toxsedyshev/imBMW/README.md

imBMW · BMW iBus integration SDK and hardware
=========================

[imBMW]: http://imBMW.net "imBMW"
[toxs]: http://toxs.ru "toxs"

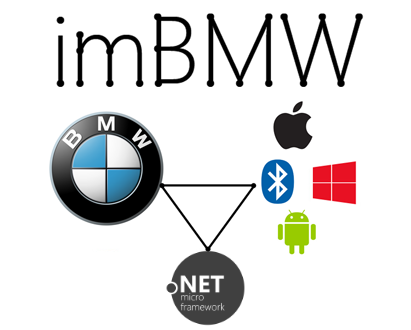
[picture p1: Images/splash.png]
imBMW Splash


[imBMW] is .NET Micro Framework and hardware project. It was started to add custom features to cars with **iBus** interface such as '91-'10 BMWs and some models of Mini, Land Rover, Rover, MG and Rolls Royce. Then **CAN BUS** support was added to integrate with newer F,I,G-series BMWs.

The Original **imBMW V1** device uses **FEZ Mini**, connects with iPod/iPhone via headset cable to be controlled by BMW audio system.

The Next Gen **imBMW V2** device, that uses **STM32F405** based **FEZ Cerb40 II**, is a *duino-compatible iBus-ready board. It could be used with any shield, for example with **imBMW Bluetooth OVC3860** or **Bluetooth Pro Bluegiga WT32 Shields** for wireless stereo audio connection to BMW audio system, handsfree calls and even for forwarding iBus via Bluetooth to smartphones, tablets and PCs - imBMW already has a library for **Universal Windows Platform (UWP)**. There is also **Diagnostic Bus DS2** support using regular OBD II to USB adapter, that allows Engine Control Unit plus additional sensors logging and wireless Bluetooth dashboard. Furthermore, **CAN BUS** support was added for sniffing and integrating with CAN modules of all BMWs since the end 90's till latest BMW models including i-series EVs — for example, CAN BUS integration allowed to [integrate BMW E65 full comfort seats into older BMW E53](https://www.youtube.com/watch?v=P0yJuep_bd4&list=PLDuwqawzvazj9iFQQ9aeggeXeUPphfv94&index=5&pp=gAQBiAQB).

CD-changer emulator and Bordmonitor AUX interface were implemented to connect radio with iPod/iPhone/iPad or with other players, phones and tablets like Windows Phone, Android etc. 
Also imBMW allows communicating with instrument cluster, immobilizer, GM, ZKE, navigation and other modules to receive notifications and control doors, windows, lights, etc.

How to buy imBMW
------------------
**Please note: I used to manufacture and sell imBMW devices but I DON'T sell them anymore.**

You can DIY the project for your personal use as many community members did, some [examples of the device forks are shown here](https://vk.com/album-67915700_260588402).

Social networks
-----------------
* Visit [imBMW YouTube playlist](http://www.youtube.com/playlist?list=PLDuwqawzvazj9iFQQ9aeggeXeUPphfv94) on my channel.
* Official group: [imBMW on vk.com](http://vk.com/imbmw).
* Stay in touch via [imbmw@toxs.ru](mailto:imbmw@toxs.ru), but please remember: I don't sell devices anymore. 
* Photos, videos and creation process of imBMW V1 and V2 devices are located on [e46club.ru forum](http://bmwfanatics.ru/forumvb/viewtopic.php?f=32&t=92399) (for now, only in Russian).

Photos
-
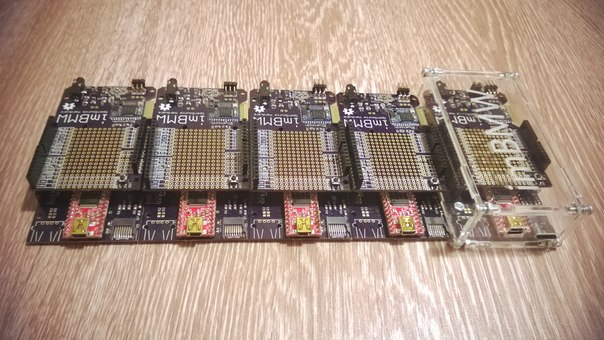
[picture p2: Images/v2_some_items.jpg]
imBMW V2 + Bluetooth first batch


Some screens for example. Playing Bluetooth music, custom bordcomputer, additional features, english and russian UI:  
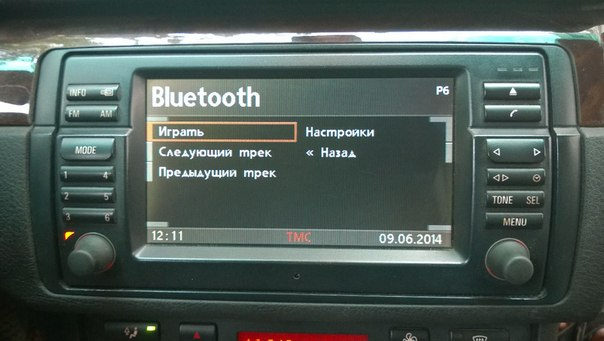
[picture p3: Images/screen_bt.jpg]
imBMW Bluetooth
  
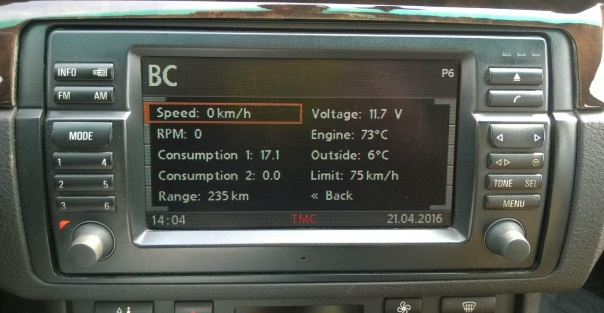
[picture p4: Images/screen_bc_en.jpg]
imBMW Bordcomputer imBMW Bordcomputer Eng
 
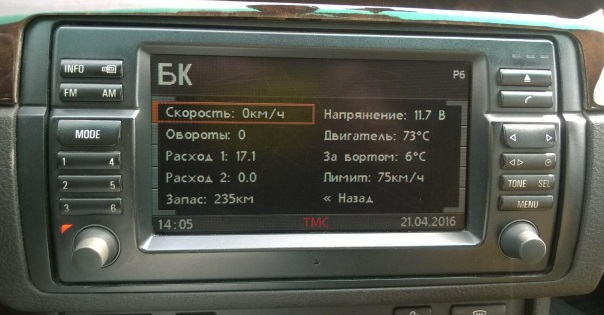
[picture p5: Images/screen_bc_ru.jpg]
imBMW Bordcomputer imBMW Bordcomputer Rus
  
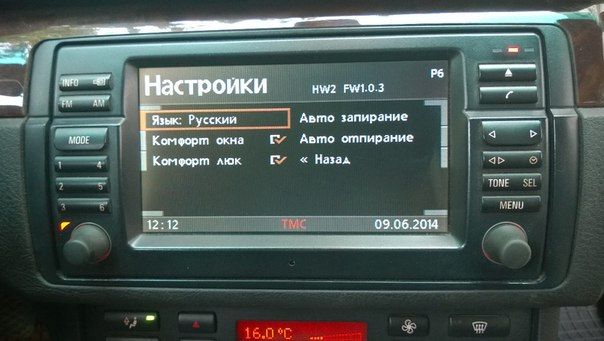
[picture p6: Images/screen_set.jpg]
imBMW Features Settings imBMW Features Settings Rus


imBMW compatability
------------------

iBus-compatible cars are listed below:
* BMW 3-series E46, E36*
* BMW 5-series E39, E34*, E60*
* BMW 7-series E38
* BMW 8-series E31*
* BMW X3 E83
* BMW X5 E53
* BMW Z4 E85, E86
* BMW Z8 E52
* MINI Cooper R50, Cooper S R53
* Land Rover Range Rover L30
* Rover 75 R40
* Saab 9-3 2003+

Notes:
* E31 uses different device IDs.
* Last 2 production years of E36 and E34 had iBus-controlled CD43 radio and CD-changers.
* E60 ver. USA had iBus-controlled seat occupation sensor.

imBMW license
------------------

[imBMW] is developed by [toxs] and distributed under Open Source
[CC Attribution Non-Commercial Share Alike License](http://creativecommons.org/licenses/by-nc-sa/3.0/). 
This basically means:
* Licensees may copy, distribute, display and perform the work and make derivative works 
based on it only if they give the author or licensor the credits in the manner specified by these.
* Licensees may copy, distribute, display, and perform the work and make derivative works 
based on it only for noncommercial purposes.
* Licensees may distribute derivative works only under a license identical to the license 
that governs the original work.

© Copyright 2013-2014 [toxs] · All Rights Reserved
