toxsedyshev/imBMW/Hardware/Cases/V2+Bluetooth_OVC3860/render/q.png

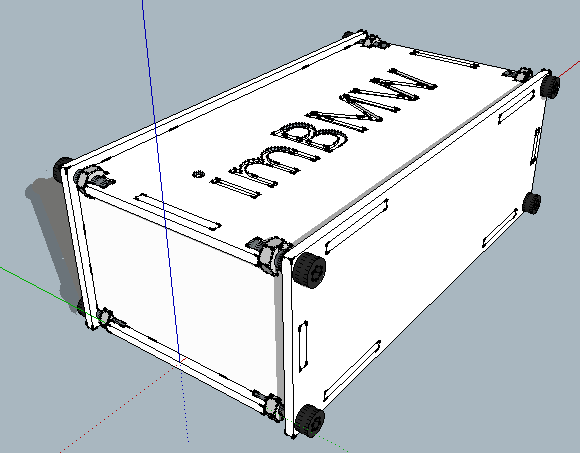
Hardware/Cases/V2+Bluetooth_OVC3860/render/q.png
