toxsedyshev/imBMW/Hardware/Cases/V2+Bluetooth_OVC3860/render/V2_OVC_proto.png

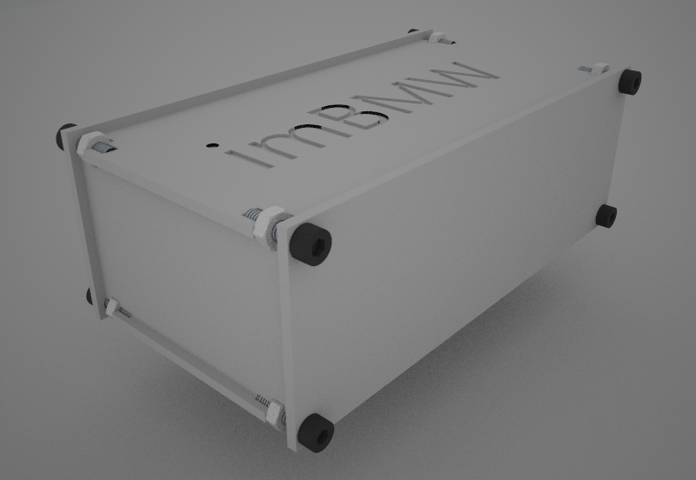
Hardware/Cases/V2+Bluetooth_OVC3860/render/V2_OVC_proto.png
