toxsedyshev/imBMW/Images/screen1.jpg

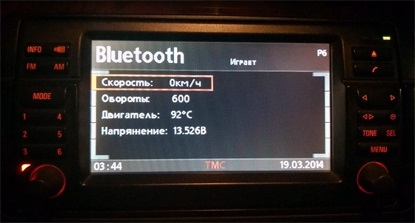
Images/screen1.jpg
