toxsedyshev/imBMW/Images/v2_proto.jpg

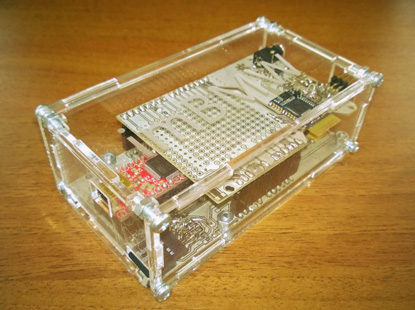
Images/v2_proto.jpg
