toxsedyshev/imBMW/Hardware/Cases/V2+Bluetooth_OVC3860/export/V2_OVC.dxf

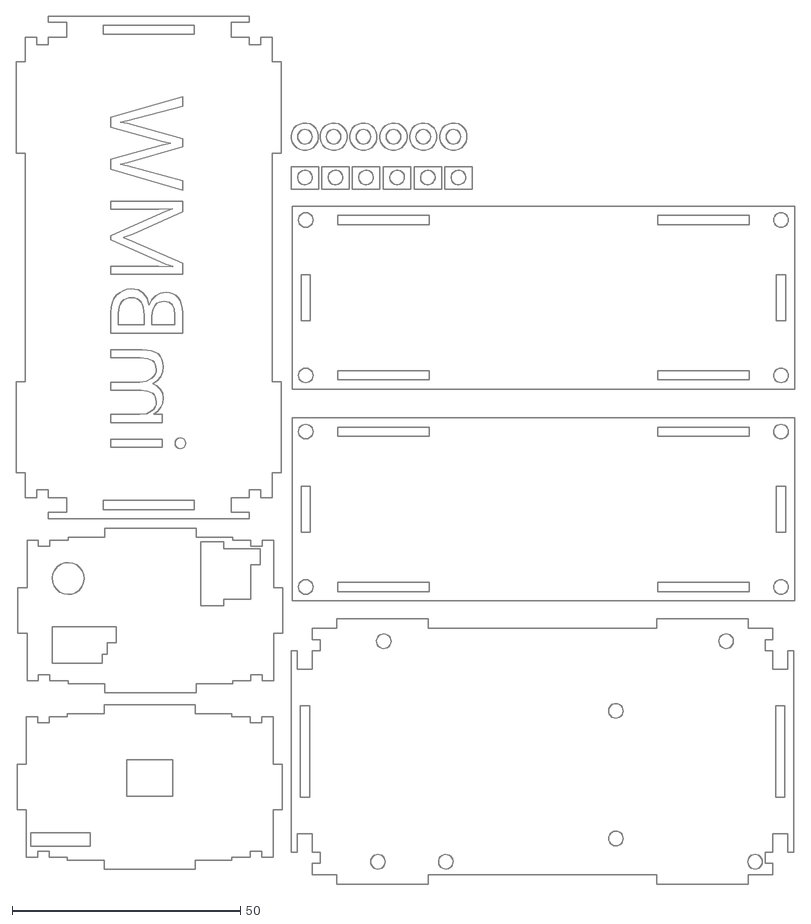
[picture p13: CAD file, 2014-10-19]
Hardware/Cases/V2+Bluetooth_OVC3860/export/V2_OVC.dxf
170.4 x 190.0
