toxsedyshev/imBMW/(list of files, cad)

Other CAD files:
Hardware/Cases/V2+Bluetooth_OVC3860/V2_OVC.skp
