toxsedyshev/imBMW/(list of files, drawings)

Other design files:
Hardware/PCB/V1/v1.DSN
Hardware/PCB/V1/v1.LYT
