toxsedyshev/imBMW/Hardware/PCB/V2/V2.brd

## EAGLE design Hardware/PCB/V2/V2.brd (2014-10-19)

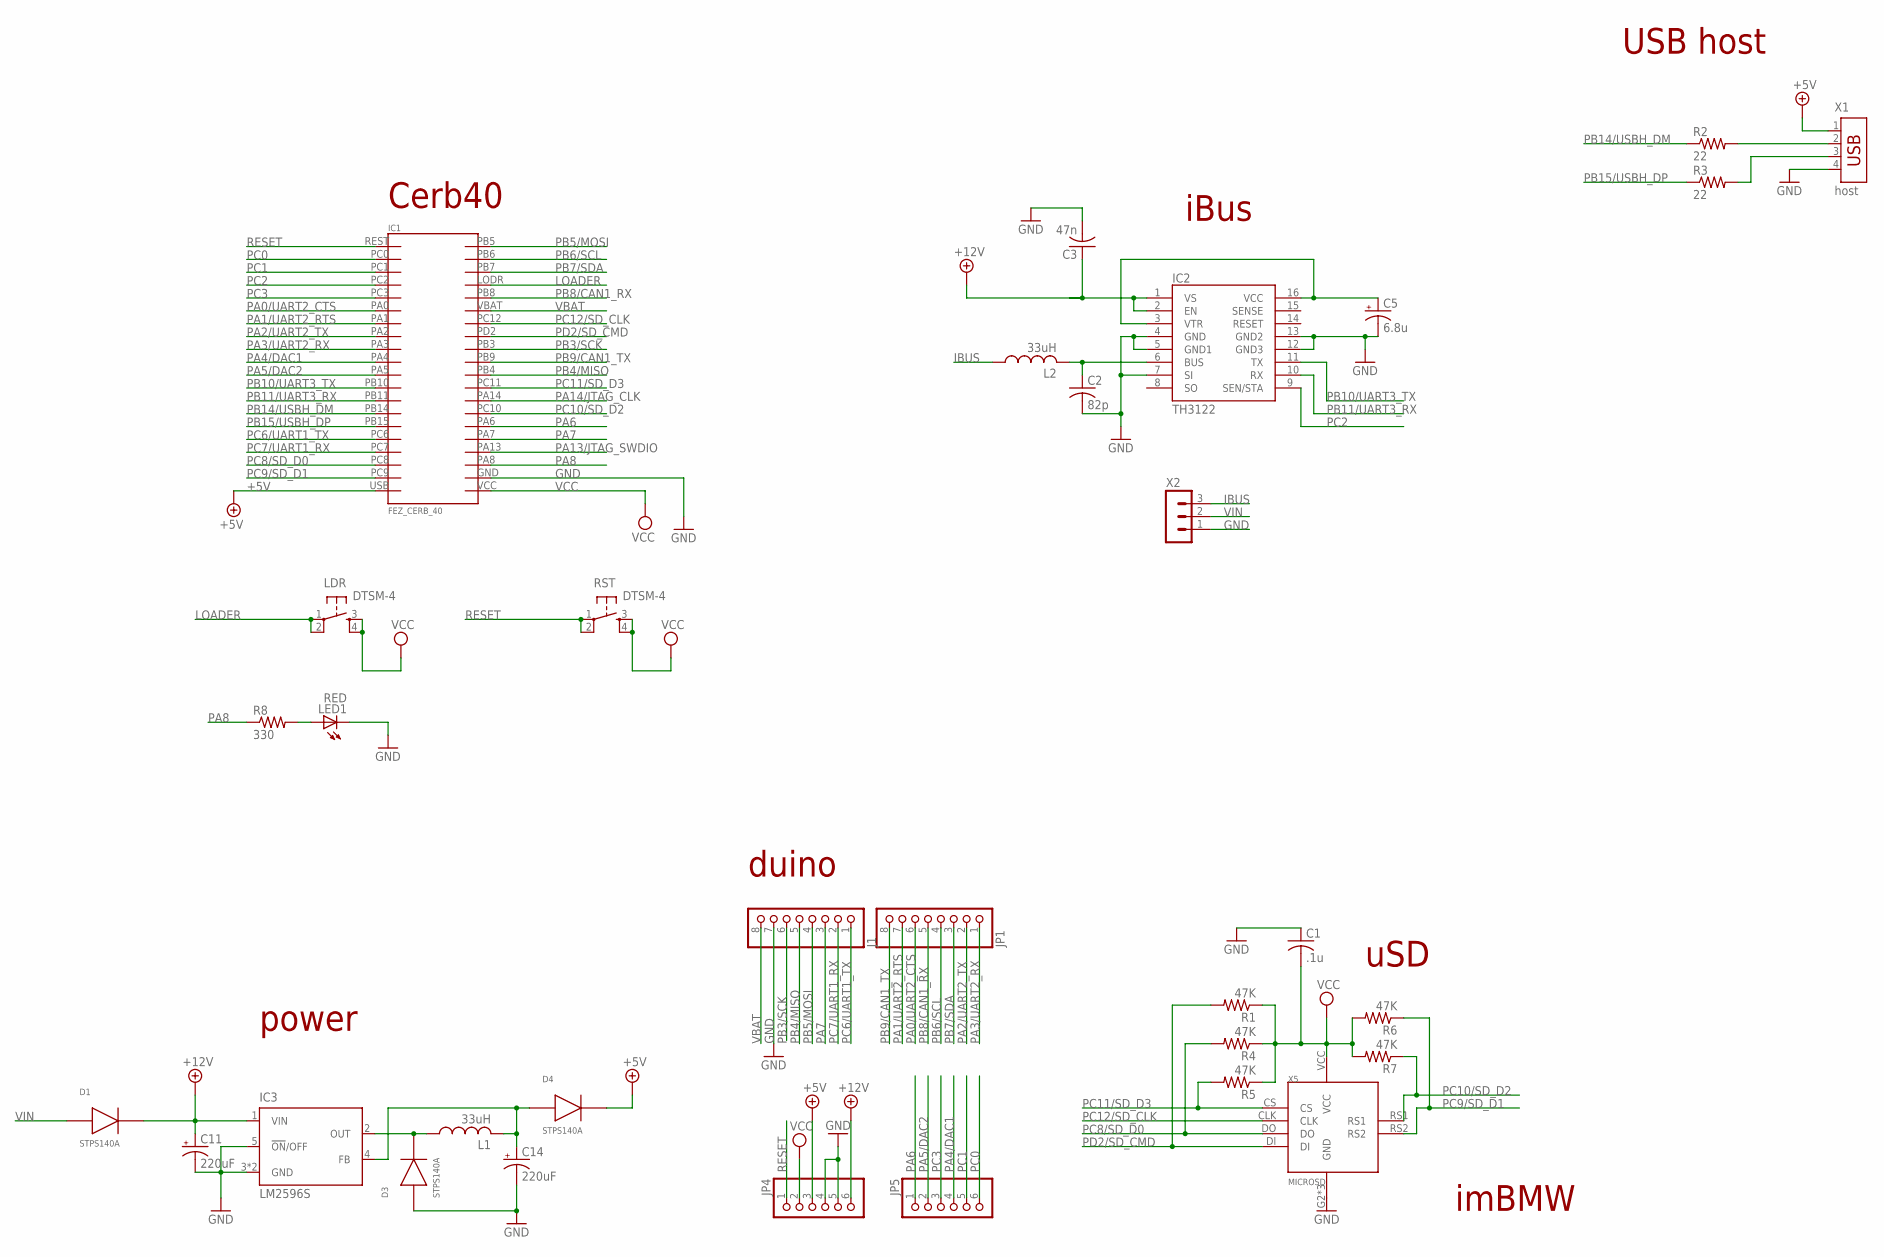
[picture p14: schematic V2.sch]

Parts:
C1: .1u; C0805
C2: 82p; C0805
C3: 47n; C0805
C5: 6.8u; SMC_B
C11, C14: 220uF; SMC_D
D1, D3, D4: STPS140A; DIODE_SMA
IC1: FEZ_CERB_40
IC2: TH3122; SO16L
IC3: LM2596S; TO263-5
J1: PINHD-1X8; 1X08
JP1: PINHD-1X8; 1X08
JP4, JP5: PINHD-1X6; 1X06
L1, L2: 33uH; POWER-CHOKE_WE-TPC
LDR: DTSM-4
LED1: RED; SML0603
R1, R4, R5, R6, R7: 47K; R0805
R2, R3: 22; R0805
R8: 330; R0805
RST: DTSM-4
X1: host; USB
X2: MA03-1
X5: MICROSD

Connections:
+5V: D4.K, IC1.USB, JP4.3, X1.1
+12V: C3.1, C11.+, D1.K, IC2.1 (VS), IC2.2 (EN), IC3.1 (VIN), JP4.6
GND: C1.1, C2.2, C3.2, C5.-, C11.-, C14.-, D3.A, IC1.GND, IC2.4 (GND), IC2.5 (GND1), IC2.7 (SI), IC2.12 (GND3), IC2.13 (GND2), IC3.3 (GND), IC3.5 (!ON!/OFF), IC3.6 (GND), J1.7, JP4.4, JP4.5, LED1.C, X1.4, X2.1, X5.G2 (GND), X5.G3 (GND), X5.GND
IBUS: L2.1, X2.3
LOADER: IC1.LODR, LDR.1, LDR.2
unnamed: C14.+, D4.A, IC3.4 (FB), L1.2
unnamed: C2.1, IC2.6 (BUS), L2.2
unnamed: D3.K, IC3.2 (OUT), L1.1
unnamed: C5.+, IC2.3 (VTR), IC2.16 (VCC)
unnamed: LED1.A, R8.2
unnamed: R2.2, X1.2
unnamed: R3.2, X1.3
PA0/UART2_CTS: IC1.PA0, JP1.6
PA1/UART2_RTS: IC1.PA1, JP1.7
PA2/UART2_TX: IC1.PA2, JP1.2
PA3/UART2_RX: IC1.PA3, JP1.1
PA4/DAC1: IC1.PA4, JP5.4
PA5/DAC2: IC1.PA5, JP5.2
PA6: IC1.PA6, JP5.1
PA7: IC1.PA7, J1.3
PA8: IC1.PA8, R8.1
PA13/JTAG_SWDIO: IC1.PA13
PA14/JTAG_CLK: IC1.PA14
PB3/SCK: IC1.PB3, J1.6
PB4/MISO: IC1.PB4, J1.5
PB5/MOSI: IC1.PB5, J1.4
PB6/SCL: IC1.PB6, JP1.4
PB7/SDA: IC1.PB7, JP1.3
PB8/CAN1_RX: IC1.PB8, JP1.5
PB9/CAN1_TX: IC1.PB9, JP1.8
PB10/UART3_TX: IC1.PB10, IC2.11 (TX)
PB11/UART3_RX: IC1.PB11, IC2.10 (RX)
PB14/USBH_DM: IC1.PB14, R2.1
PB15/USBH_DP: IC1.PB15, R3.1
PC0: IC1.PC0, JP5.6
PC1: IC1.PC1, JP5.5
PC2: IC1.PC2, IC2.9 (SEN/STA)
PC3: IC1.PC3, JP5.3
PC6/UART1_TX: IC1.PC6, J1.1
PC7/UART1_RX: IC1.PC7, J1.2
PC8/SD_D0: IC1.PC8, R4.2, X5.DO
PC9/SD_D1: IC1.PC9, R6.1, X5.RS2
PC10/SD_D2: IC1.PC10, R7.1, X5.RS1
PC11/SD_D3: IC1.PC11, R5.2, X5.CS
PC12/SD_CLK: IC1.PC12, X5.CLK
PD2/SD_CMD: IC1.PD2, R1.2, X5.DI
RESET: IC1.REST, JP4.1, RST.1, RST.2
VBAT: IC1.VBAT, J1.8
VCC: C1.2, IC1.VCC, JP4.2, LDR.3, LDR.4, R1.1, R4.1, R5.1, R6.2, R7.2, RST.3, RST.4, X5.VCC
VIN: D1.A, X2.2

Notes on the sheet:
imBMW
uSD
duino
power
USB host
iBus
Cerb40

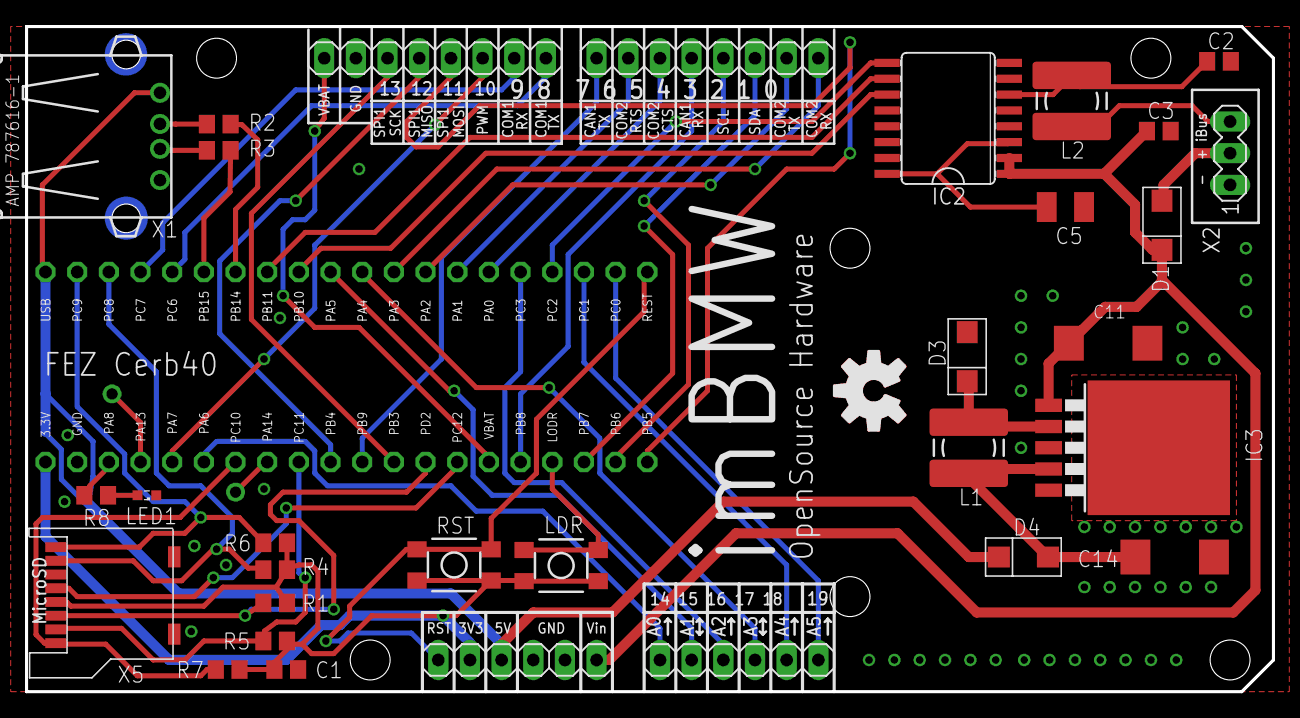
[picture p15: board V2.brd from above]

Board: 2 copper layers, 100.0 x 53.3 mm, 32 parts (0 on the bottom side), 48 nets.
