toxsedyshev/imBMW/Hardware/PCB/Shields/Bluetooth_OVC3860/BT_3860.brd

## EAGLE design Hardware/PCB/Shields/Bluetooth_OVC3860/BT_3860.brd (2014-10-19)

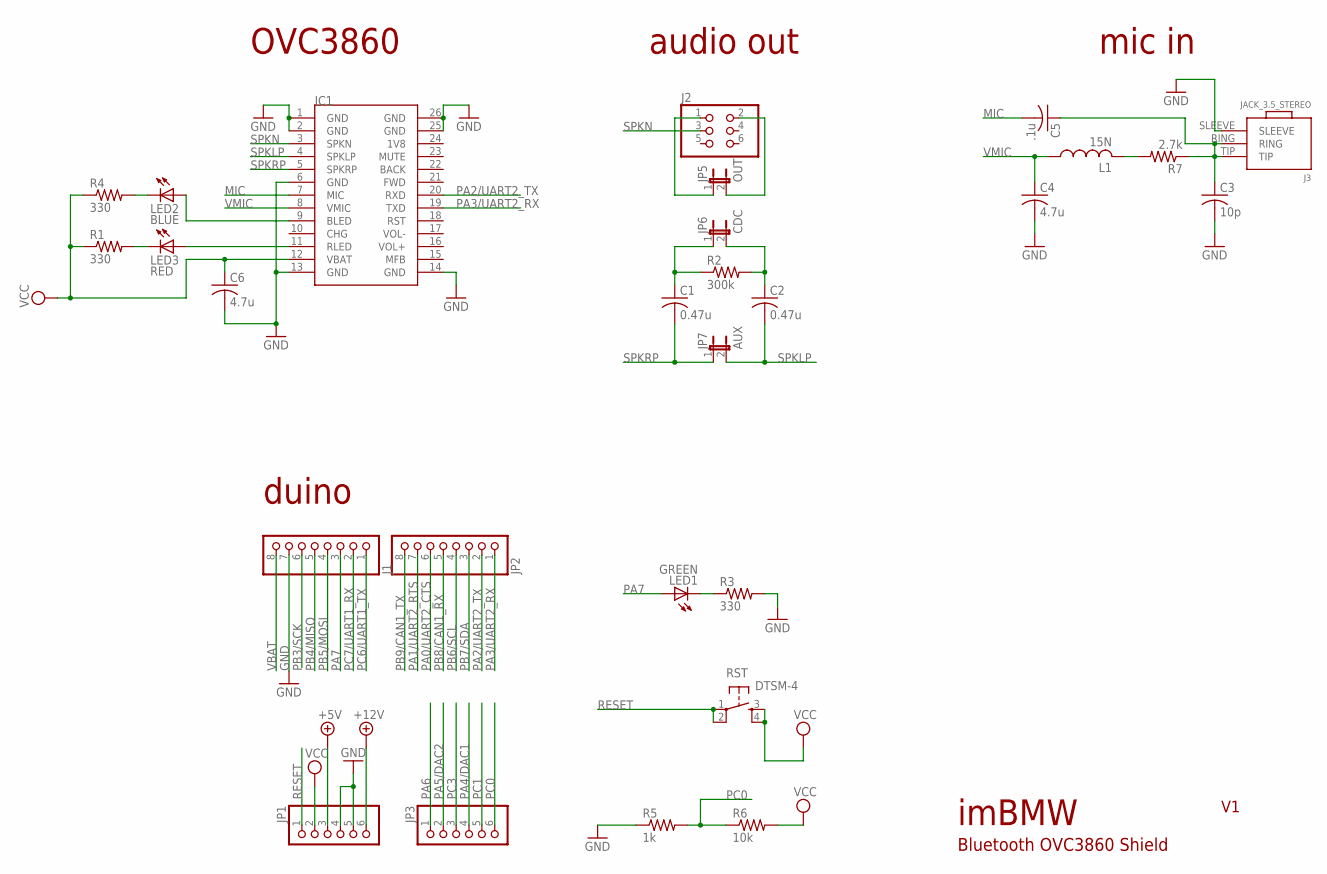
[picture p16: schematic BT_3860.sch]

Parts:
C1, C2: 0.47u; C0805
C3: 10p; C0805
C4, C6: 4.7u; C0805
C5: .1u; C0805
IC1: BLK-MD-SPK-B
J1: PINHD-1X8; 1X08
J2: PINHD-2X3; 2X03
J3: JACK_3.5_STEREO
JP1, JP3: PINHD-1X6; 1X06
JP2: PINHD-1X8; 1X08
JP5: OUT; JP1
JP6: CDC; JP1
JP7: AUX; JP1
L1: 15N; L3230M
LED1: GREEN; SML0603
LED2: BLUE; SML0603
LED3: RED; SML0603
R1, R3, R4: 330; R0805
R2: 300k; R0805
R5: 1k; R0805
R6: 10k; R0805
R7: 2.7k; R0805
RST: DTSM-4

Connections:
+5V: JP1.3
+12V: JP1.6
GND: C3.2, C4.2, C6.2, IC1.1 (GND), IC1.2 (GND), IC1.6 (GND), IC1.13 (GND), IC1.14 (GND), IC1.25 (GND), IC1.26 (GND), J1.7, J3.SLEEVE, JP1.4, JP1.5, R3.2, R5.1
MIC: C5.2, IC1.7 (MIC)
unnamed: C2.1, JP6.2, R2.2
unnamed: C1.1, JP6.1, R2.1
unnamed: J2.1, JP5.1
unnamed: J2.2, JP5.2
unnamed: LED1.C, R3.1
unnamed: LED3.C, R1.2
unnamed: IC1.11 (RLED), LED3.A
unnamed: IC1.9 (BLED), LED2.A
unnamed: LED2.C, R4.2
unnamed: C3.1, C5.1, J3.RING, J3.TIP, R7.1
unnamed: L1.2, R7.2
PA0/UART2_CTS: JP2.6
PA1/UART2_RTS: JP2.7
PA2/UART2_TX: IC1.20 (RXD), JP2.2
PA3/UART2_RX: IC1.19 (TXD), JP2.1
PA4/DAC1: JP3.4
PA5/DAC2: JP3.2
PA6: JP3.1
PA7: J1.3, LED1.A
PB3/SCK: J1.6
PB4/MISO: J1.5
PB5/MOSI: J1.4
PB6/SCL: JP2.4
PB7/SDA: JP2.3
PB8/CAN1_RX: JP2.5
PB9/CAN1_TX: JP2.8
PC0: JP3.6, R5.2, R6.1
PC1: JP3.5
PC3: JP3.3
PC6/UART1_TX: J1.1
PC7/UART1_RX: J1.2
RESET: JP1.1, RST.1, RST.2
SPKLP: C2.2, IC1.4 (SPKLP), JP7.2
SPKN: IC1.3 (SPKN), J2.3
SPKRP: C1.2, IC1.5 (SPKRP), JP7.1
VBAT: J1.8
VCC: C6.1, IC1.12 (VBAT), JP1.2, R1.1, R4.1, R6.2, RST.3, RST.4
VMIC: C4.1, IC1.8 (VMIC), L1.1

Notes on the sheet:
imBMW
duino
Bluetooth OVC3860 Shield
OVC3860
audio out
mic in

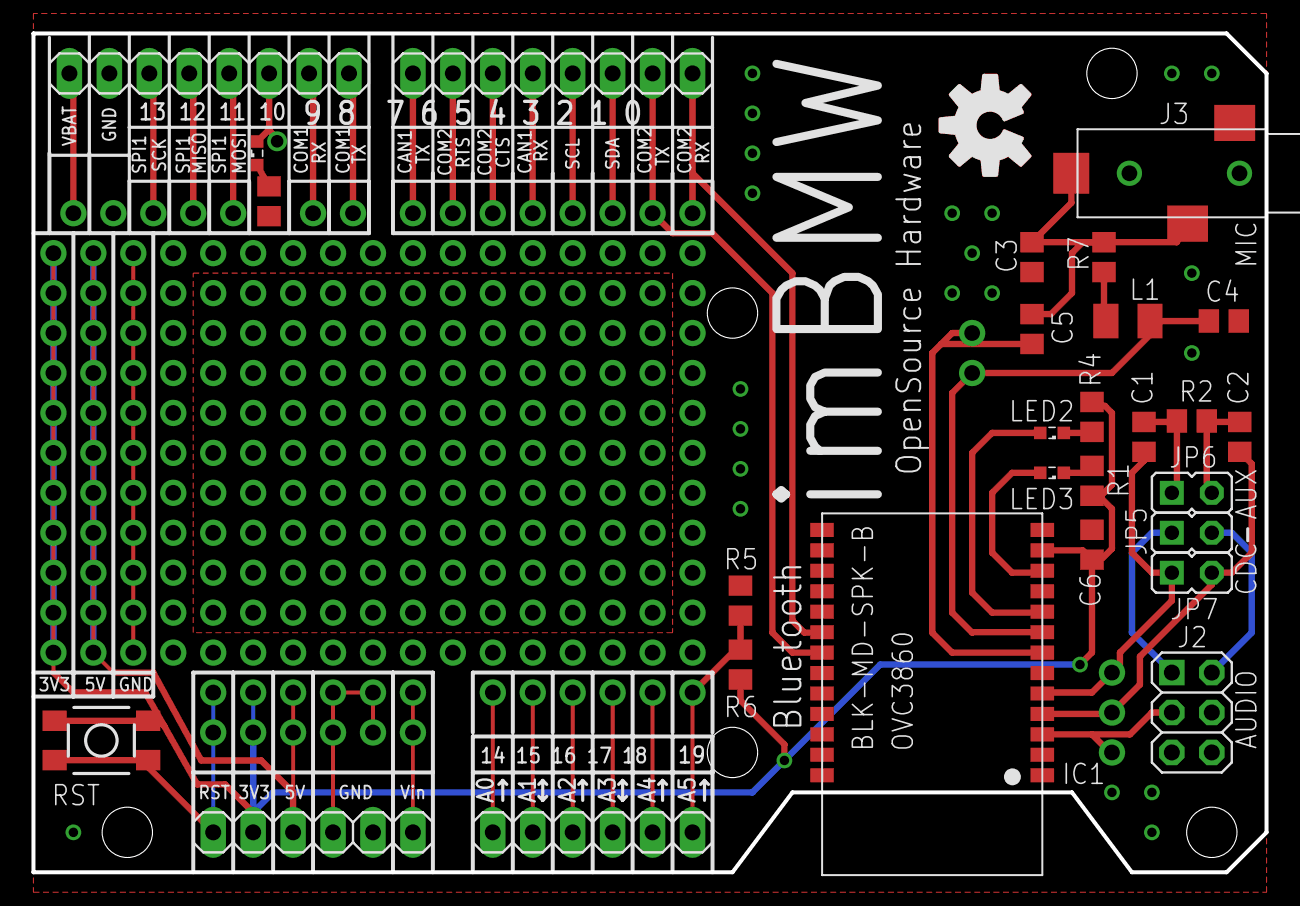
[picture p17: board BT_3860.brd from above]

Board: 2 copper layers, 78.4 x 53.3 mm, 28 parts (0 on the bottom side), 23 nets.
