toxsedyshev/imBMW/(threads)

Thread 4 (2021-08-02):

Where to source FEZ Cerb40 II

damienmaguire, 2021-08-02:
The FEZ Cerb40 II seems to be out of stock / discontinued. Any alternates available?

toxsedyshev, 2021-08-02:
There are several options, using original imBMW V2 main board or making changes to imBMW mainboard, making custom board or using another board with [Point-to-point construction](https://en.wikipedia.org/wiki/Point-to-point_construction) instead of plug-n-play connection:
- Build your own FEZ Cerb40 II, since it's opensource. But legacy info was removed from GHI website and I can't find .brd in my files, only [schematics PDF](http://files.ghielectronics.com/downloads/Schematics/FEZ/FEZ%20Cerb40%20II%20Rev%202.0%20Schematic.pdf) is available for now. Asked for backup files [here](https://forums.ghielectronics.com/t/fez-cerb40-ii-eagle-files/13572/9).
- Use any .NETMF GHI SDK supported board, the easiest way is to buy any STM32F405 based board like many micro-python boards: [ali](https://www.aliexpress.com/item/1005001922826474.html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,searchweb201602_,searchweb201603_) or [adafruit](https://learn.adafruit.com/adafruit-stm32f405-feather-express/circuitpython-setup) etc
- Build [imBMW V3 main board](https://vk.com/album-67915700_227365616). It wasn't released since it wasn't tested yet. I'll send you Eagle files to Telegram.

There are several community [forks of imBMW](https://vk.com/album-67915700_260588402) project using options listed above.
