toxsedyshev/imBMW/(commit log)

2013-01-18 Schematics and PCB design added
    [v1.DSN, v1.LYT]
2013-01-26 PCB updated
    [v1.DSN, v1.LYT]
2013-01-28 Added display text for playing state fix by RND button
2013-01-29 ClassDiagram added and PCB updated
    [v1.LYT]
2013-03-01 imBMW library and imBMW V1 device separated to different projects
2013-03-15 Write anti-flood changed to 5ms, read processing moved to the main thread
2013-03-22 Batch iBus sending, PerformanceInfo, SampleFeatures
2013-03-31 TimeSpan print fix. StringHelpers added
2013-03-31 Comfort features commands queue. Blink LED on I/O.
2013-04-26 iBus optopair adapter pcb added
    [v1-ibus-optopair-adapter.DSN, v1-ibus-optopair-adapter.LYT]
2013-04-29 iBus optopair adapter pcb updated
    [v1-ibus-optopair-adapter.DSN, v1-ibus-optopair-adapter.LYT]
2013-05-07 XPS for toner transfer method of V1 PCB added
2014-03-18 Find device on iBus, Bluetooth fixes, Contacts parsing, Temperature, Voltage
    Unstable
2014-05-05 Remote key buttons fix
2014-05-06 MB menu flickering fixes. CDC emulation fixes. Init fixed.
    + Driver door lock. Gong messages. Menu checkbox fixes.
    Not tested!
2014-05-23 RadioMenu added, Contacts fixed, MK2 fixed, V1 device updated
2014-05-28 V1 device fix
2014-05-28 BC voltage auto update
2014-06-05 Radio menu: track change fixed, BC screen fixed.
2014-06-08 Radio menu track change fixed
2014-07-19 Radio MFL navigation fixed. Device V2 pins added. Tests added.
2014-07-19 BC voltage fix.
2014-10-19 Project structure changed
    [v1-ibus-optopair-adapter.DSN, v1-ibus-optopair-adapter.LYT, v1.DSN, v1.LYT]
2014-10-19 Added V2 and Bluetooth OVC3860 Eagle projects. Added case projects. Builds moved.
    [BT_3860.brd, BT_3860.sch, V2.brd, V2.sch, V2_OVC.dxf, V2_OVC.skp, v1-ibus-optopair-adapter.DSN, v1-ibus-optopair-adapter.LYT]
2014-11-23 BM<>Radio buttons and events.
2014-11-24 WT32 pin change support.
2014-11-24 SocketClient fixed.
2014-11-24 MessageParser used in SocketClient.
2015-01-22 Added Init() for static iBus device classes
2015-02-01 V2 device pins refactored.
2015-04-03 Unlock doors after driver door opened reverted.
2015-04-10 Device.V1 .NET MF 4.1 memory limit fixes
2016-04-05 MID menu buttons added.
2016-04-14 Added mask to MID menu last buttons.
2016-04-14 Fixed battery voltage on BC.
2018-08-22 CAN BUS adapters implementation.
    Native GHI NETMF and MCP2515 CAN BUS adapters added.
2018-08-22 Pins, SPI, CAN refactoring.
2018-09-24 CAN BUS fixes.
2018-09-24 E65 seats CAN BUS emulation.
    Emulation of CAN BUS "wakeup" messages to make E65 "comfort" seats work.
    Partly implemented.
2019-01-16 E65 seats auto heater activation.
2019-02-05 Device launcher.
2019-02-05 Can Bus MCP2515 adapter deprecated.
2019-02-08 Device projects directories renamed.
2019-04-03 Added all MS43 + BlackBox sensors gauges.
2019-04-07 UWP: Threading fixes.
2019-07-15 Added CSU iBus device.
2021-05-24 CanBus refactoring and optimizations.
    CanBus read queue is NOT optimized yet for high load.
2021-05-24 Junk data removed from canbus packet.
